alexr007/int-barrel-2023/doc/IMG_7269.jpeg

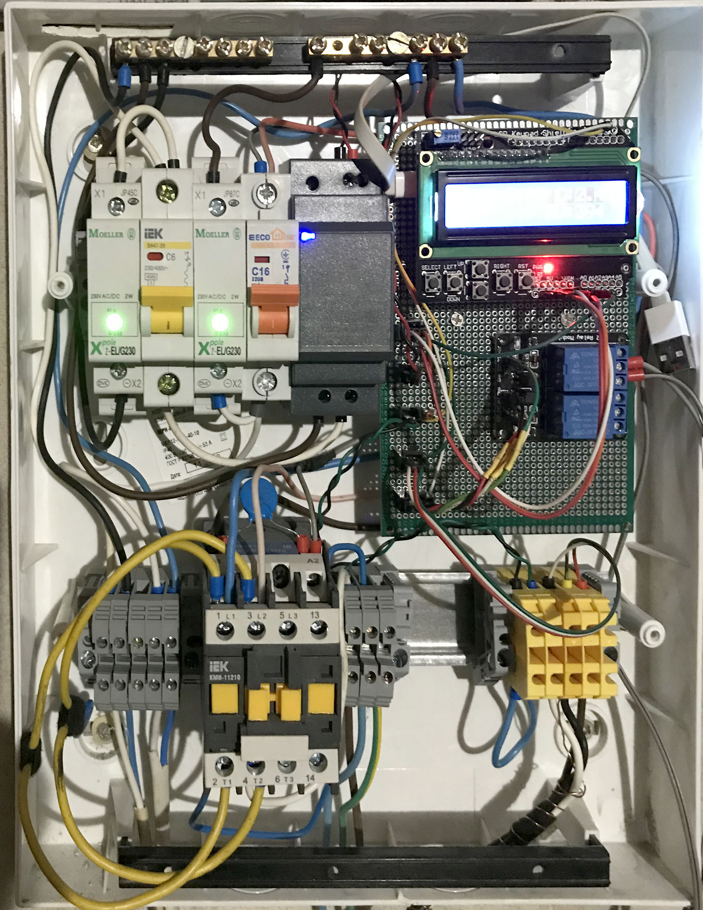
doc/IMG_7269.jpeg
