alexr007/int-barrel-2023/doc/IMG_7270.jpg

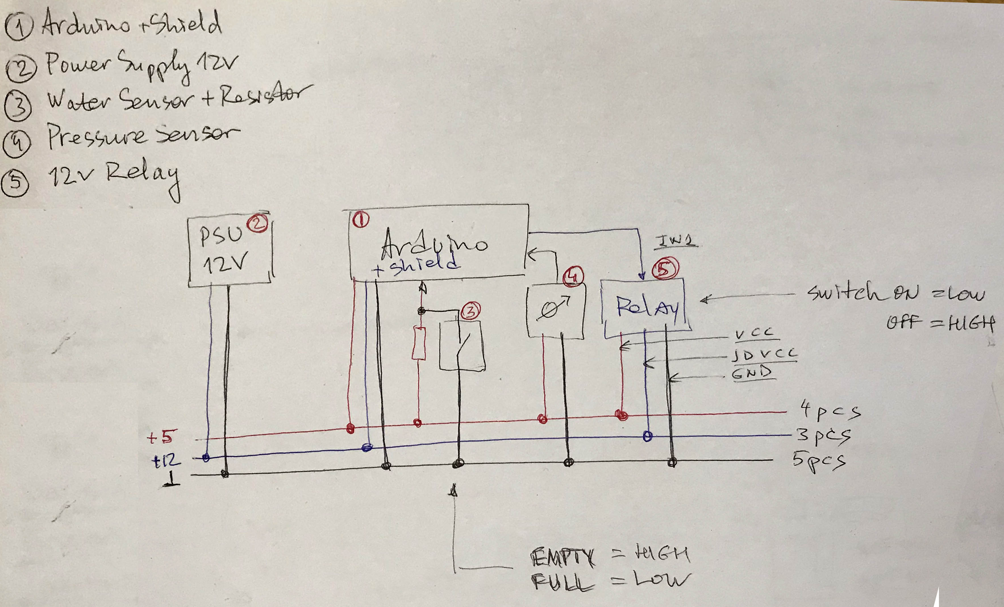
doc/IMG_7270.jpg
