alexr007/int-barrel-2023/doc/IMG_7272.jpg

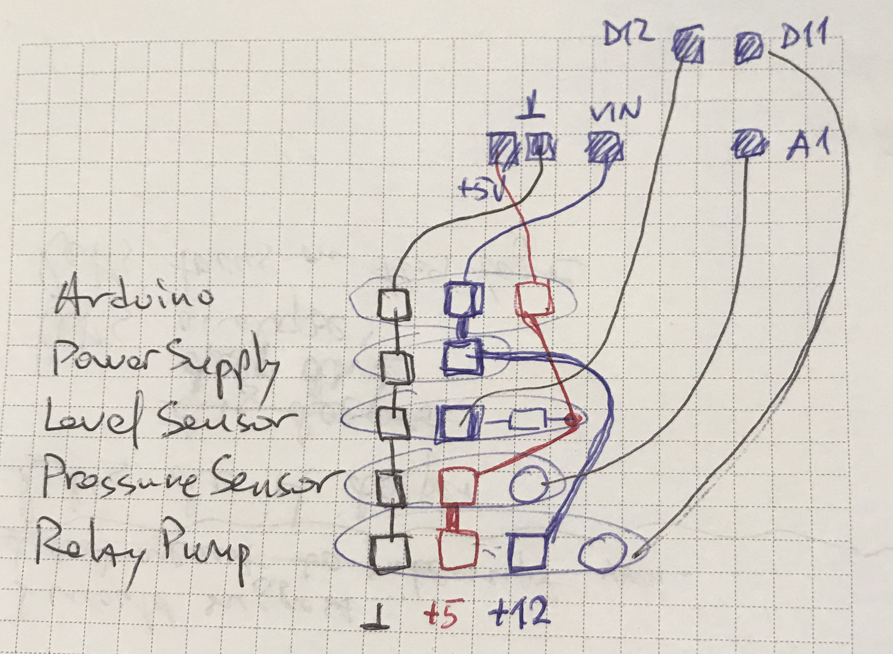
doc/IMG_7272.jpg
