alexr007/int-barrel-2023/doc/arduino_ports.xlsx

arduino uno |  |  | shield
ANALOG
A0 |  |  | Keyboard
A1 |  |  |  | PORT_PRESSURE_SENSOR
A2
A3
A4 | I2C - SDA
A5 | I2C - SCL
DIGITAL | 20 mA (40 max), 200ma total
D0 |  | serial RX
D1 |  | serial TX
D2 |  | INT0
D3 | PWM capable | INT1
D4 |  |  | LCD
D5 | PWM capable |  | LCD
D6 | PWM capable |  | LCD
D7 |  |  | LCD
D8 |  |  | LCD
D9 | PWM capable |  | LCD
D10 | PWM capable | SPI - SS
D11 | PWM capable | SPI - SCK |  | PORT_RELAY_PUMP
D12 |  | SPI - MISO |  | PORT_BARREL_IS_EMPTY
D13 | build-in LED | SPI - MOSI
AREF
ISCP | GND
 | 5V
 | RESET2
 | SCK2
 | MISO2
 | MOSI2
