alexr007/int-barrel-2023/(commit log)

2019-12-28 -- v.0.5 -- README.md -- .gitignore -- new folder structure -- doc folder -- devops folder
    [pressure sensor.xlsx]
2020-12-13 -- v.0.6 -- code polished
    [arduino_ports.xlsx]
2020-12-16 -- docs attached
2023-02-08 -- initial value for relay -- liveness indicator
2023-04-20 -- min/max pressure
